reijnlapere/PGG-Ageing-Young/emerging_tech/emerging_tech.md

opkomende technologiën project 
**!belangrijk!** kies nog een licentie, maar vraag waar je deze moet aanduiden/ingeven 

ook nog onduidelijk wat gitignore is.. dus vragen. 

## Visuele weergave opstelling 
<p align="center">
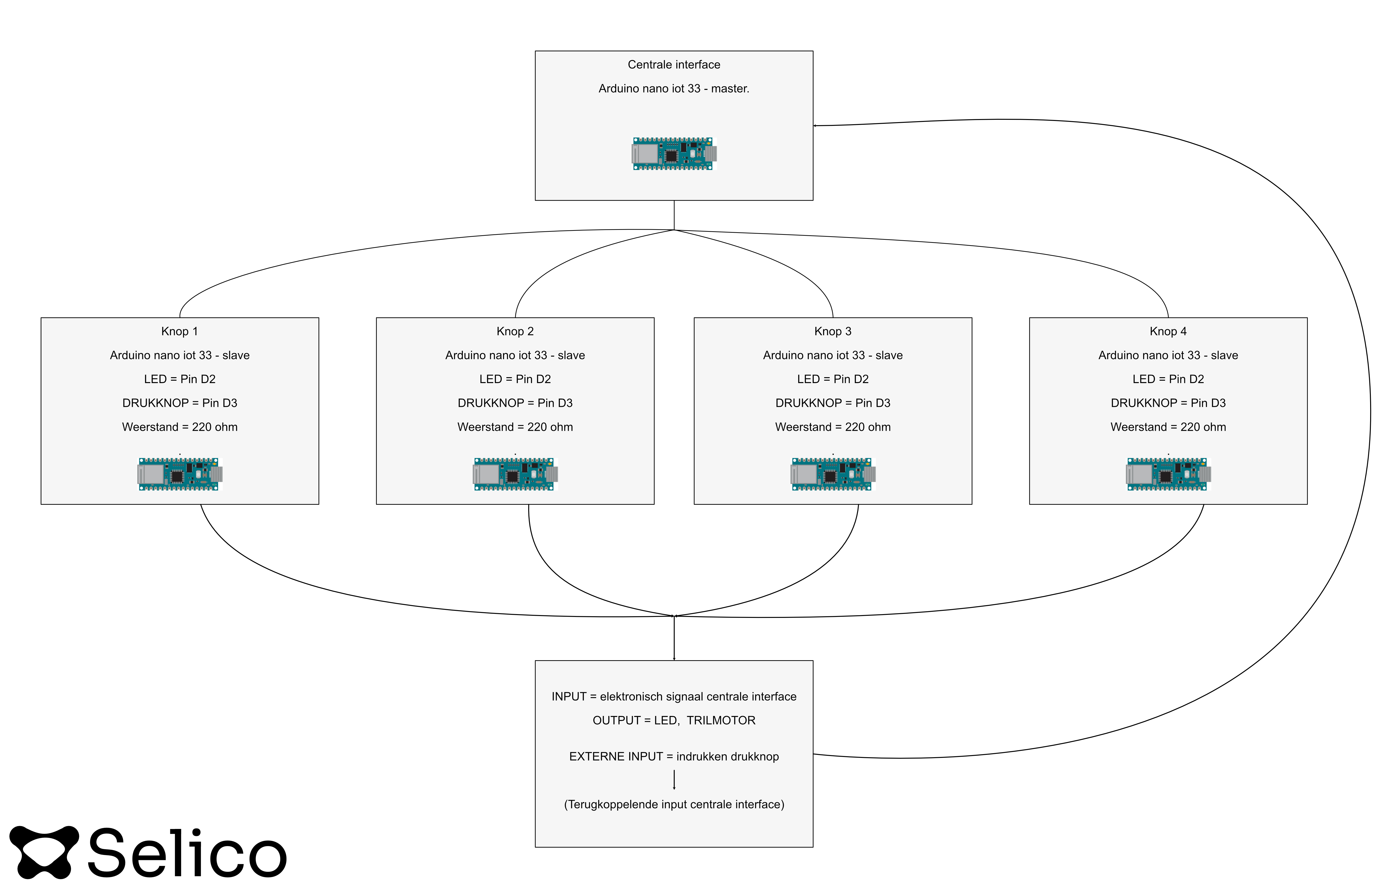
[picture p59: emerging_tech/images/opstelling grafisch.jpg]
  

## Bedradingsschema
