reijnlapere/PGG-Ageing-Young/emerging_tech/imgs/arduino-nano-33-iot-pinout.webp

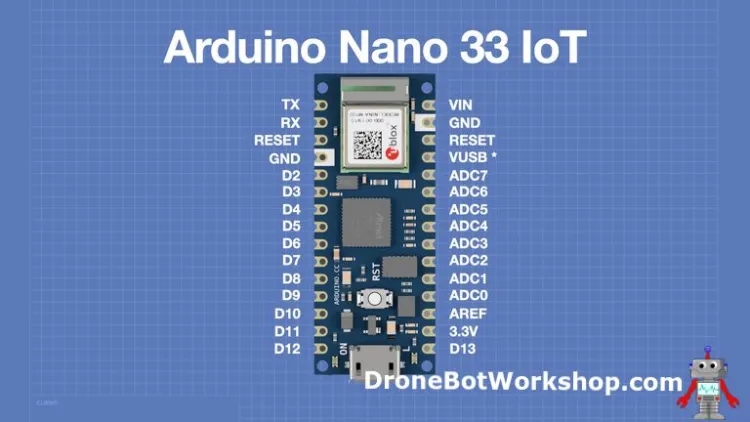
emerging_tech/imgs/arduino-nano-33-iot-pinout.webp
