reijnlapere/PGG-Ageing-Young/images/5WH.png

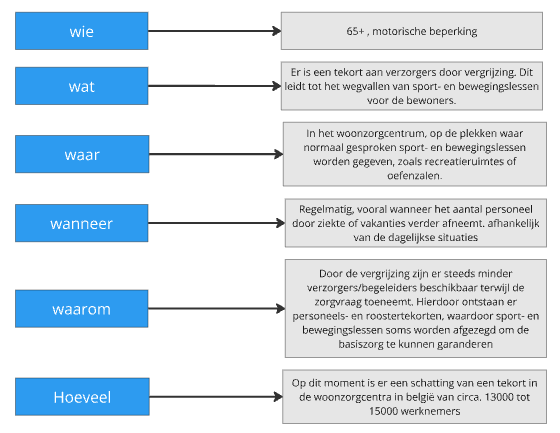
images/5WH.png
