reijnlapere/PGG-Ageing-Young/images/Afbeelding van WhatsApp op 2025-05-18 om 19.23.48_1e9d7f2c.jpg

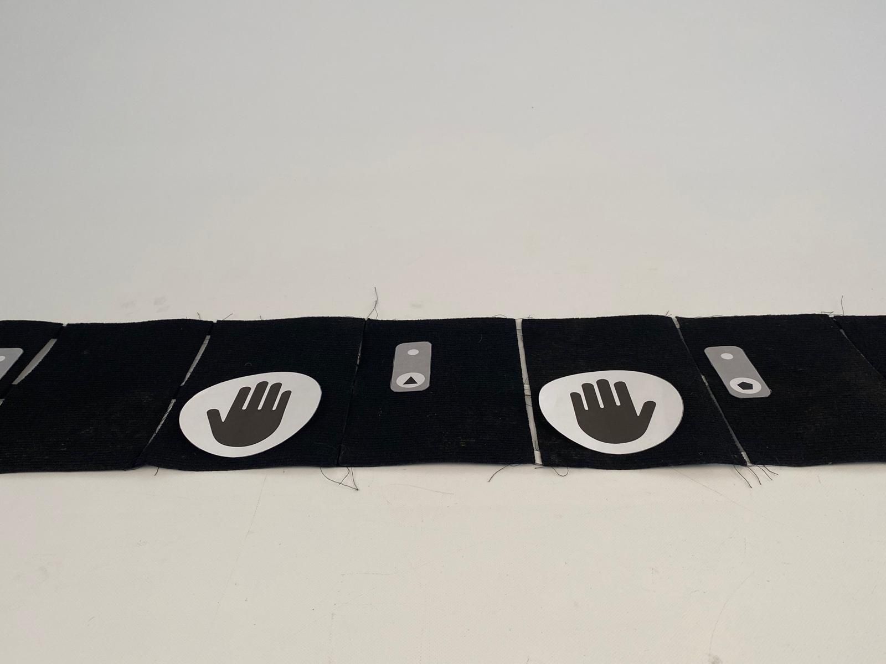
images/Afbeelding van WhatsApp op 2025-05-18 om 19.23.48_1e9d7f2c.jpg
