reijnlapere/PGG-Ageing-Young/images/Afbeelding van WhatsApp op 2025-05-18 om 19.23.48_4a3d5f69.jpg

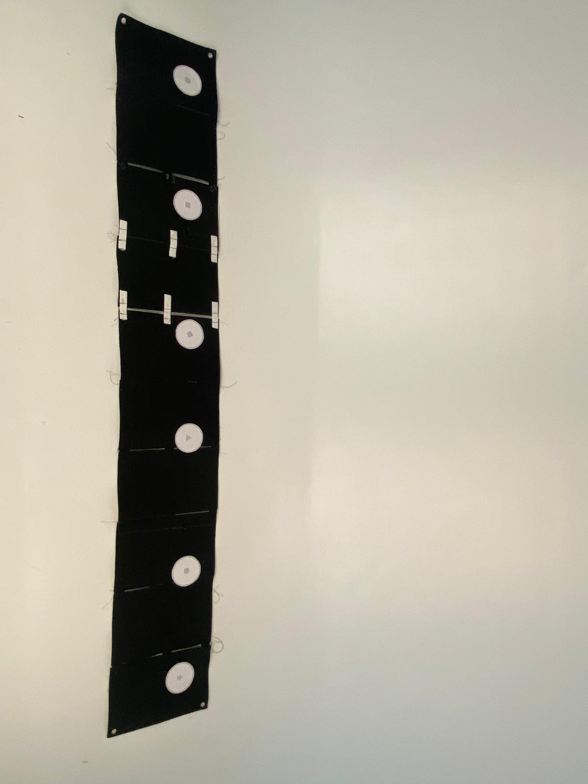
images/Afbeelding van WhatsApp op 2025-05-18 om 19.23.48_4a3d5f69.jpg
