reijnlapere/PGG-Ageing-Young/images/Afbeelding van WhatsApp op 2025-05-18 om 19.23.48_9bfd3e1f.jpg

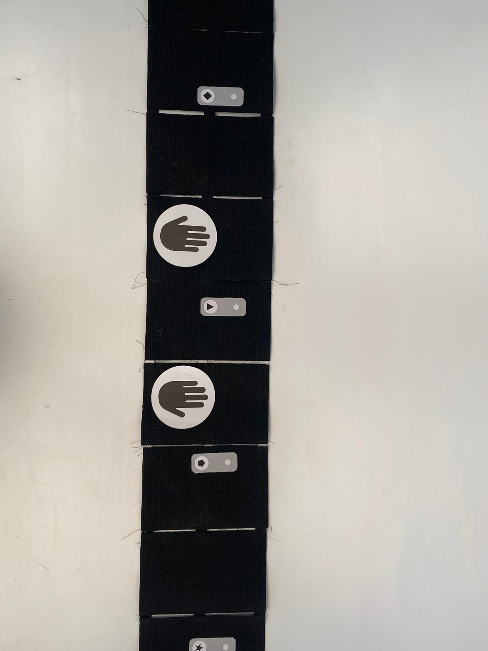
images/Afbeelding van WhatsApp op 2025-05-18 om 19.23.48_9bfd3e1f.jpg
