reijnlapere/PGG-Ageing-Young/images/D2 - 4knop en aanduiding.jpeg

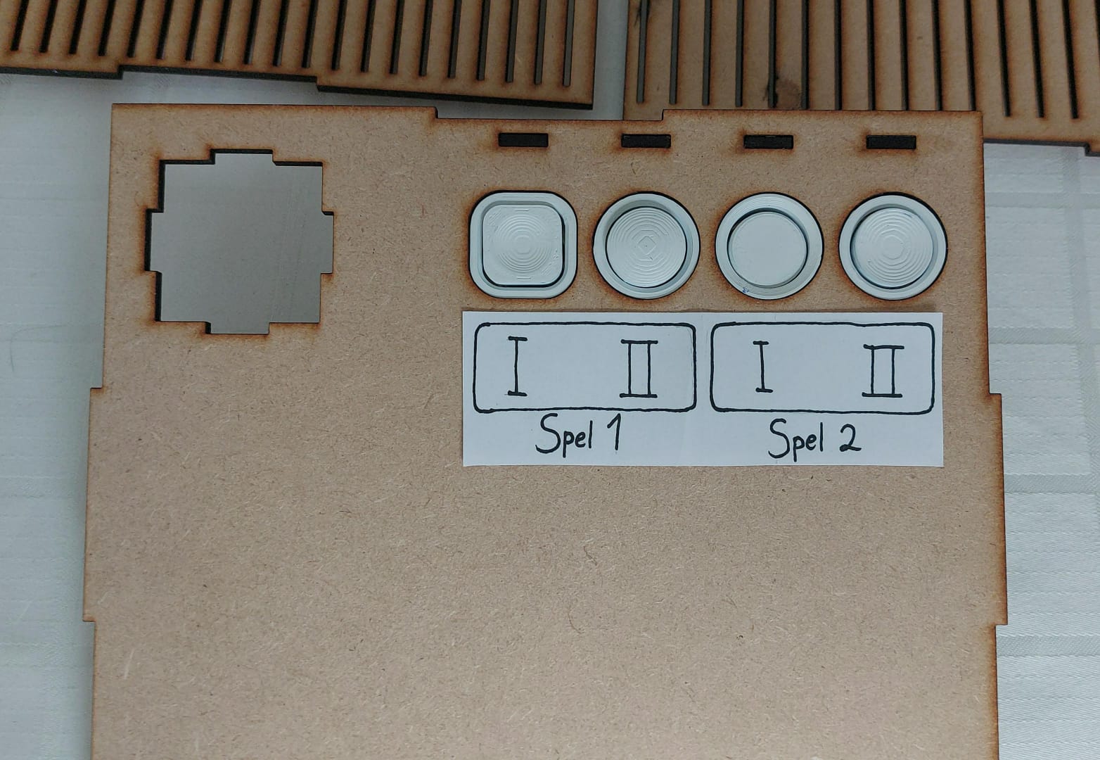
images/D2 - 4knop en aanduiding.jpeg
