reijnlapere/PGG-Ageing-Young/images/D2 - aanduidingen.jpeg

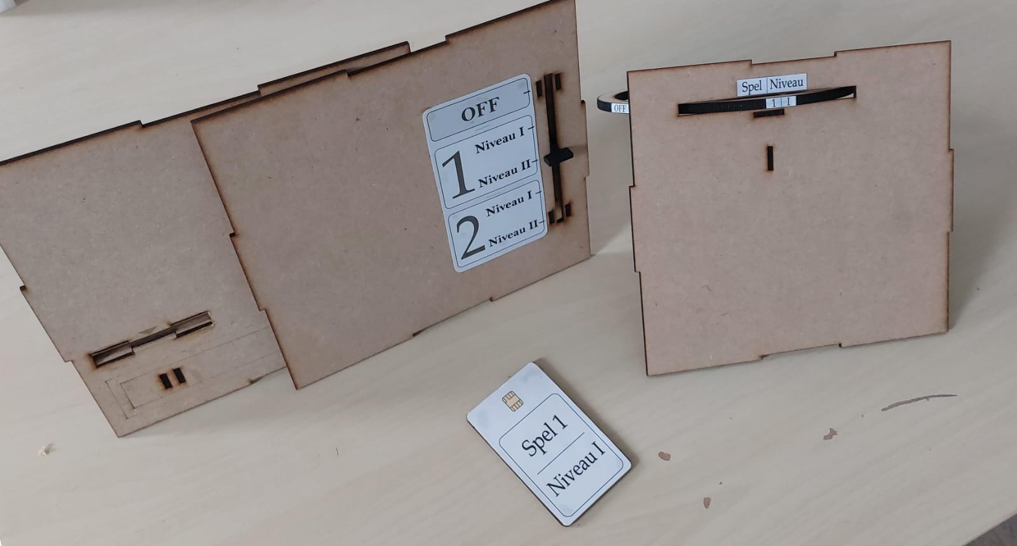
images/D2 - aanduidingen.jpeg
