reijnlapere/PGG-Ageing-Young/images/D2 - dial - NX.png

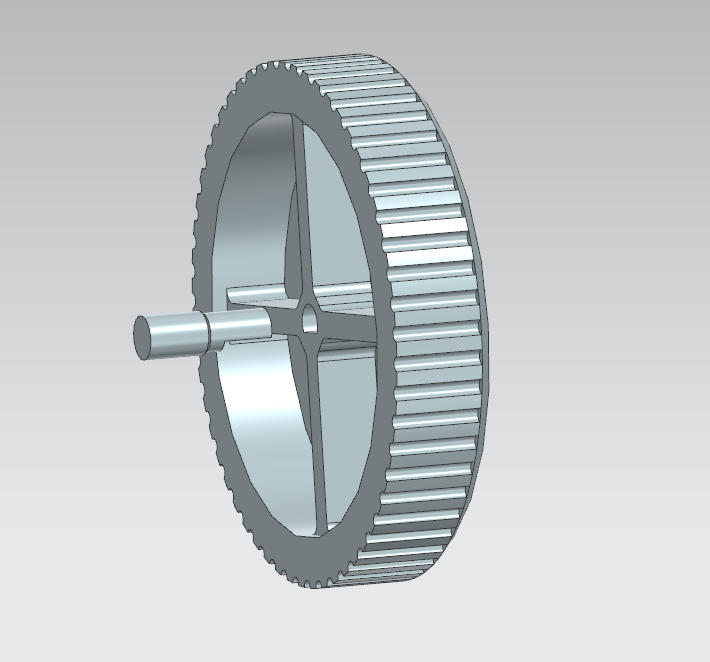
images/D2 - dial - NX.png
