reijnlapere/PGG-Ageing-Young/images/D2 - interchangable.jpeg

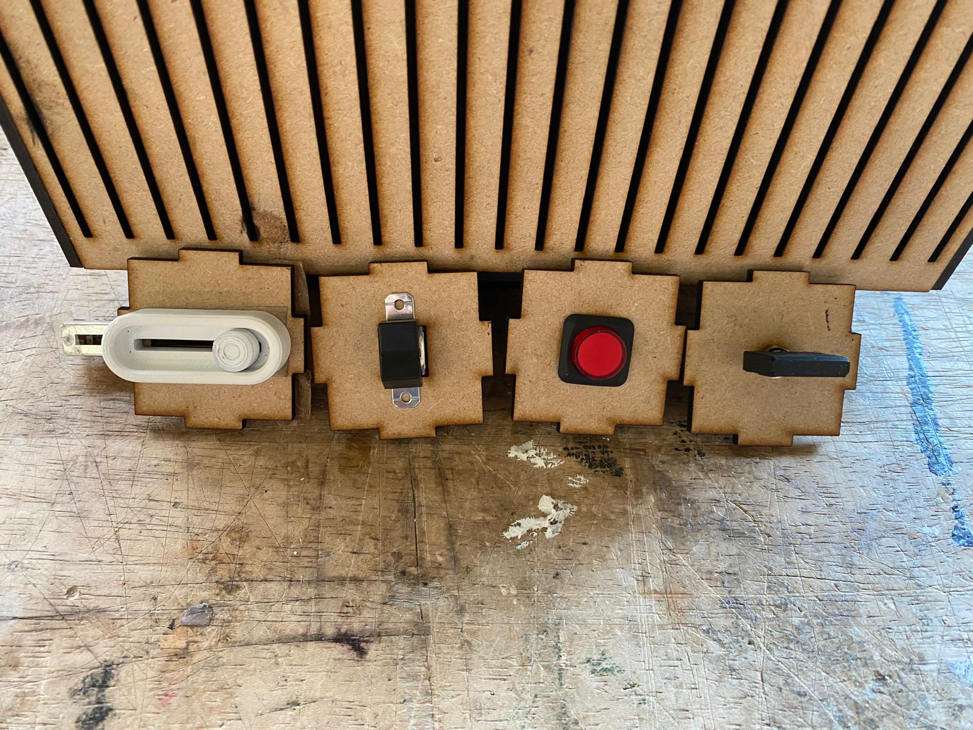
images/D2 - interchangable.jpeg
