reijnlapere/PGG-Ageing-Young/images/D2 - slider - verticaal achterkant.png

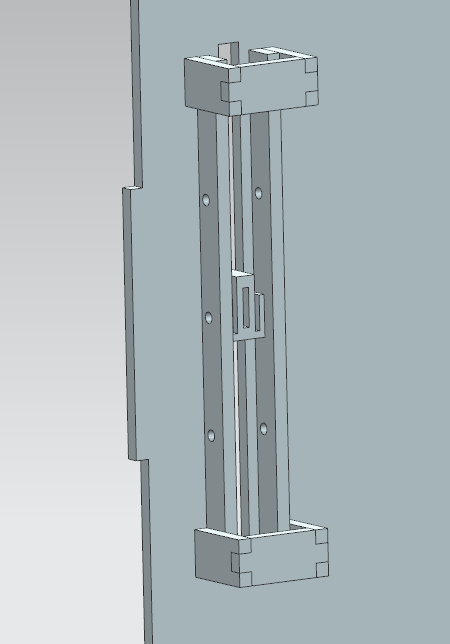
images/D2 - slider - verticaal achterkant.png
