reijnlapere/PGG-Ageing-Young/images/D2-gamecard2.jpg

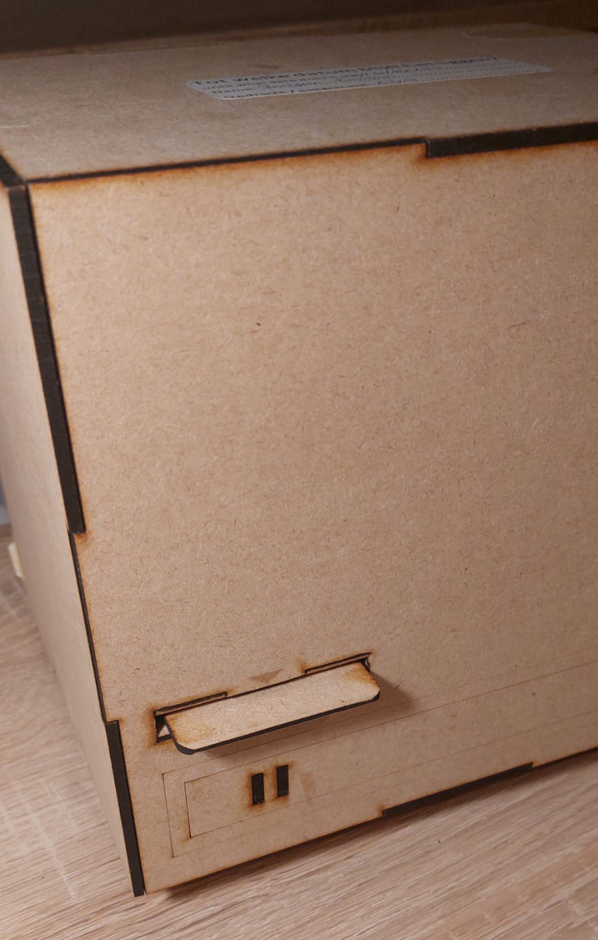
images/D2-gamecard2.jpg
