reijnlapere/PGG-Ageing-Young/images/D2-gamecard.jpeg

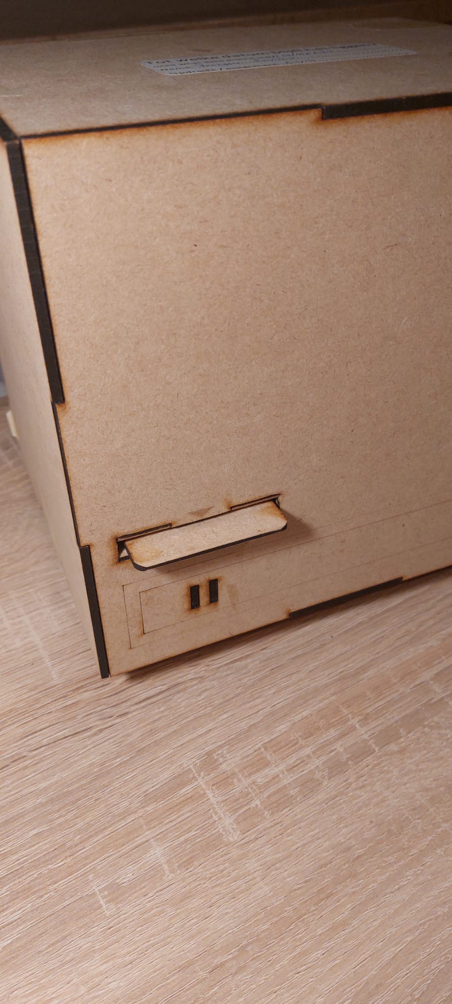
images/D2-gamecard.jpeg
