reijnlapere/PGG-Ageing-Young/images/D2-slider-aanduiding.jpeg

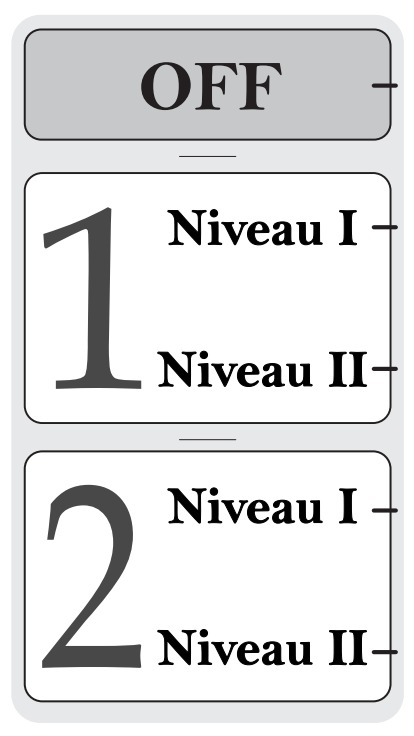
images/D2-slider-aanduiding.jpeg
