reijnlapere/PGG-Ageing-Young/images/Develop IM1.jpeg

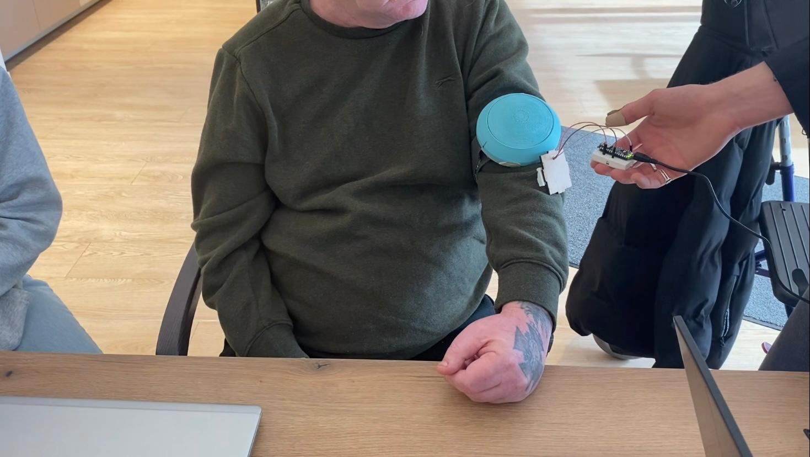
images/Develop IM1.jpeg
