reijnlapere/PGG-Ageing-Young/images/Develop IM3.jpeg

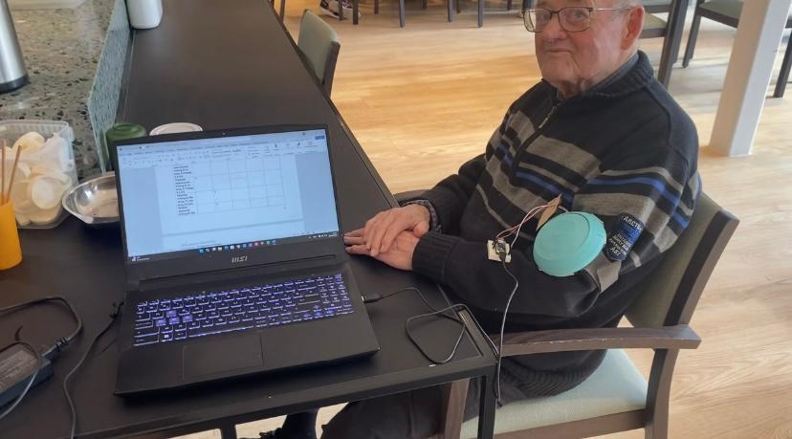
images/Develop IM3.jpeg
