reijnlapere/PGG-Ageing-Young/images/Develop IM5.jpeg

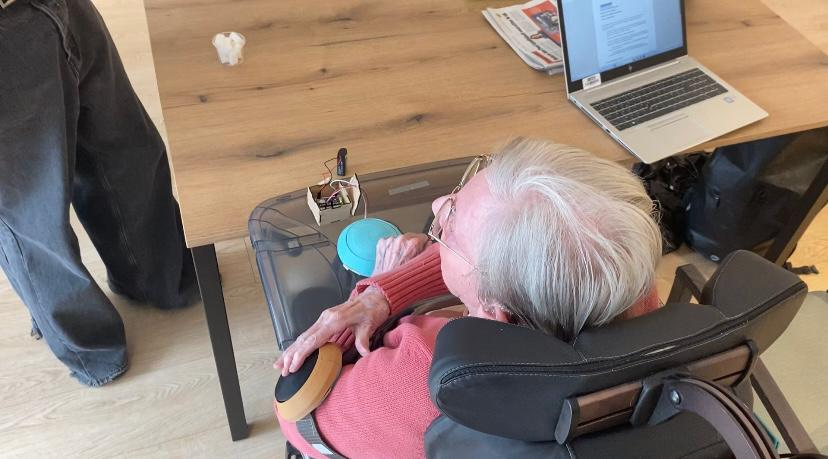
images/Develop IM5.jpeg
