reijnlapere/PGG-Ageing-Young/images/innovatrix.png

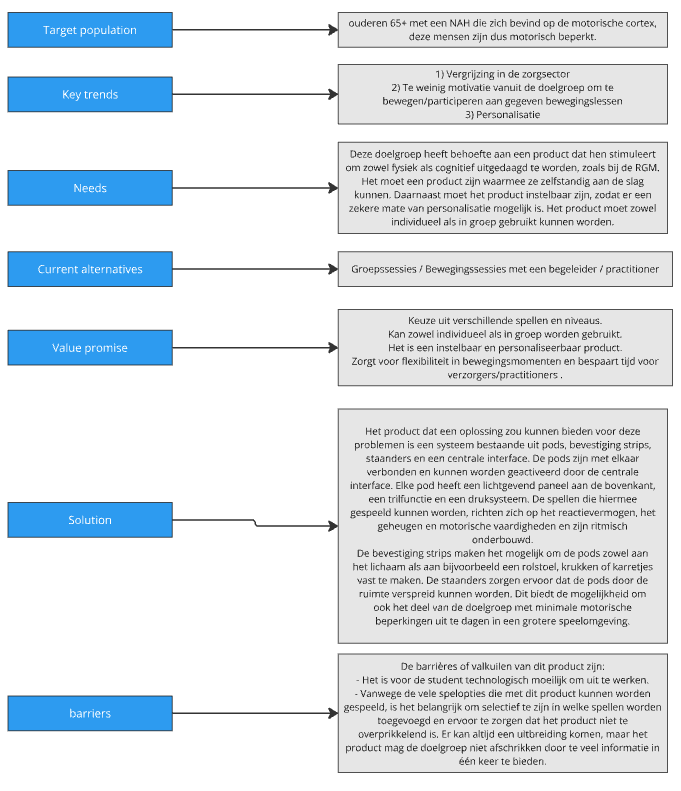
images/innovatrix.png
