reijnlapere/PGG-Ageing-Young/images/interface knopjes.jpg

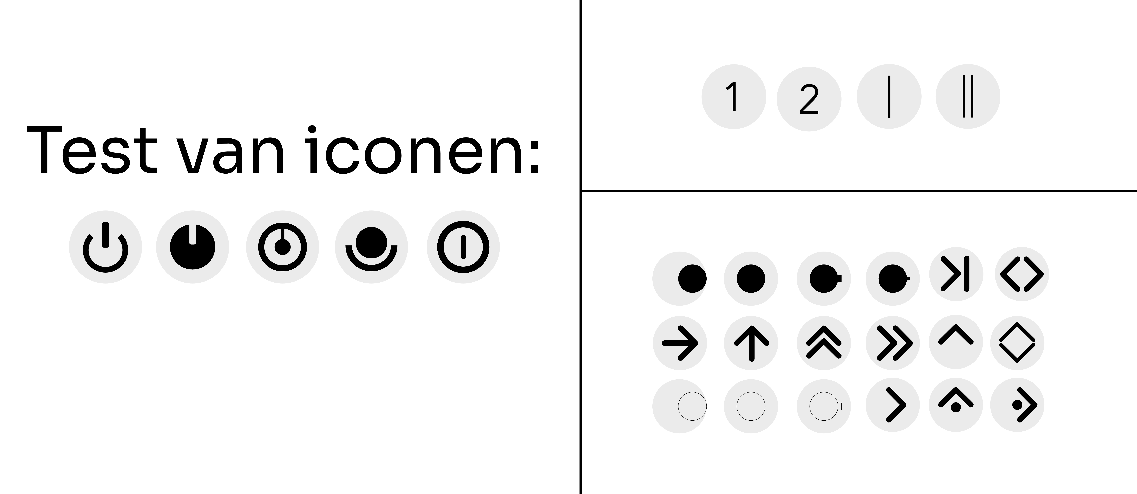
images/interface knopjes.jpg
