reijnlapere/PGG-Ageing-Young/images/POD_AANSPAN1.jpeg

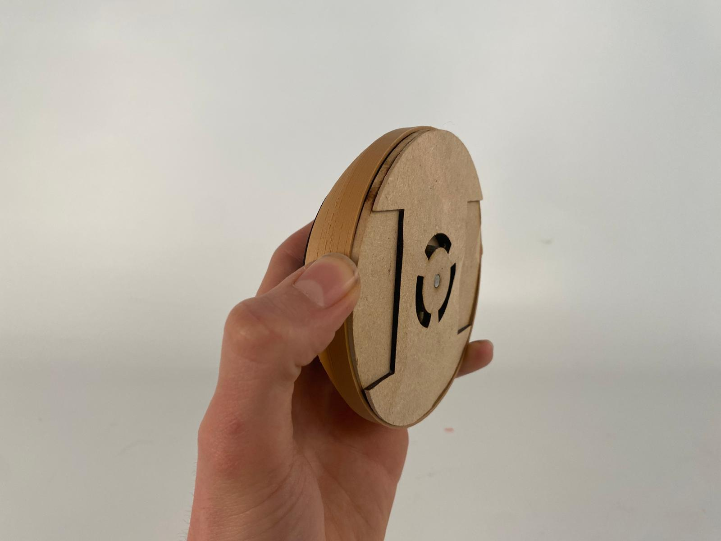
images/POD_AANSPAN1.jpeg
