reijnlapere/PGG-Ageing-Young/images/Render24 dial Finn.png

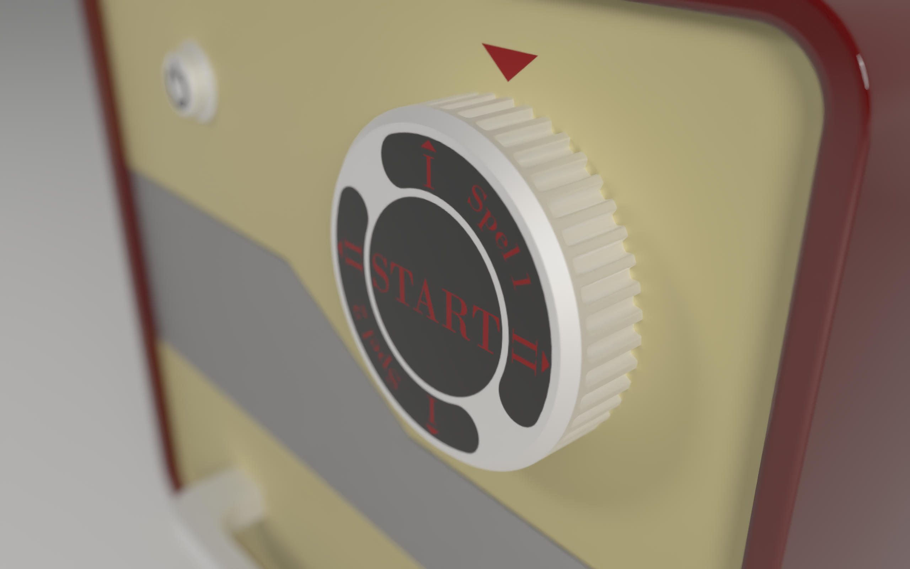
images/Render24 dial Finn.png
