reijnlapere/PGG-Ageing-Young/images/Render27 open Finnal.png

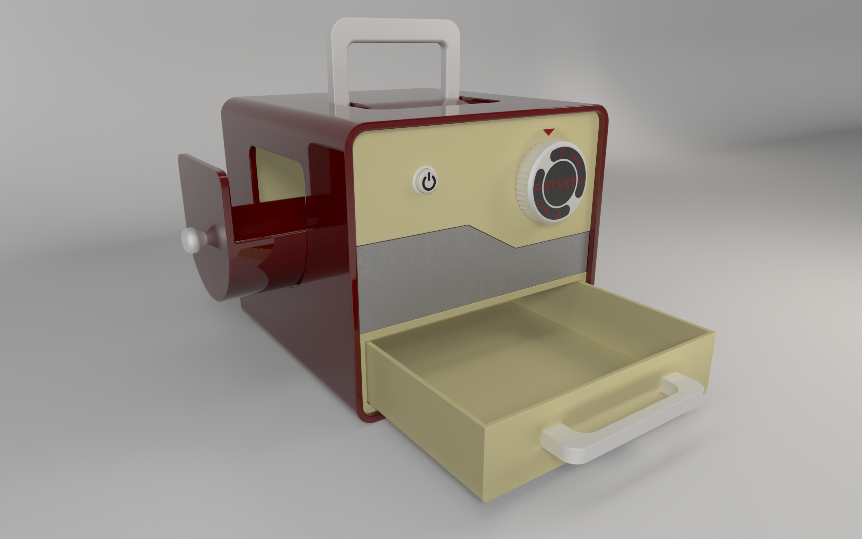
images/Render27 open Finnal.png
