reijnlapere/PGG-Ageing-Young/images/Schermafbeelding 2025-05-03 114111.png

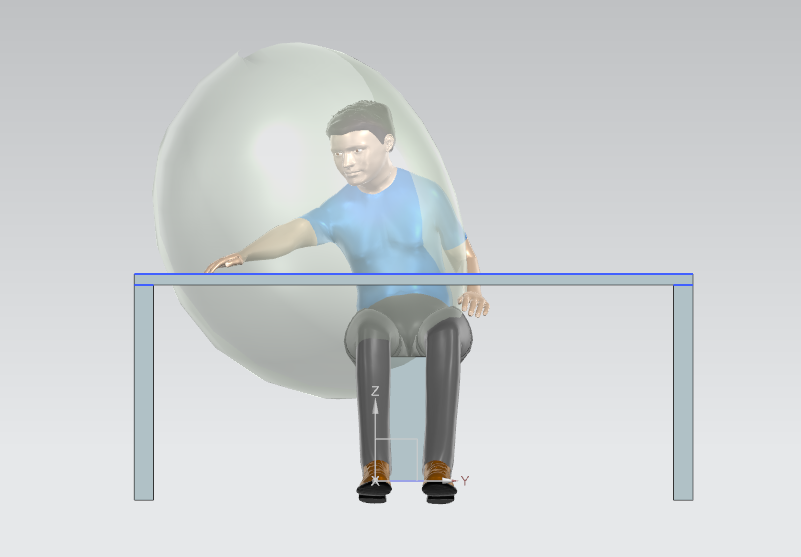
images/Schermafbeelding 2025-05-03 114111.png
