reijnlapere/PGG-Ageing-Young/images/Schermafbeelding 2025-05-21 014410.png

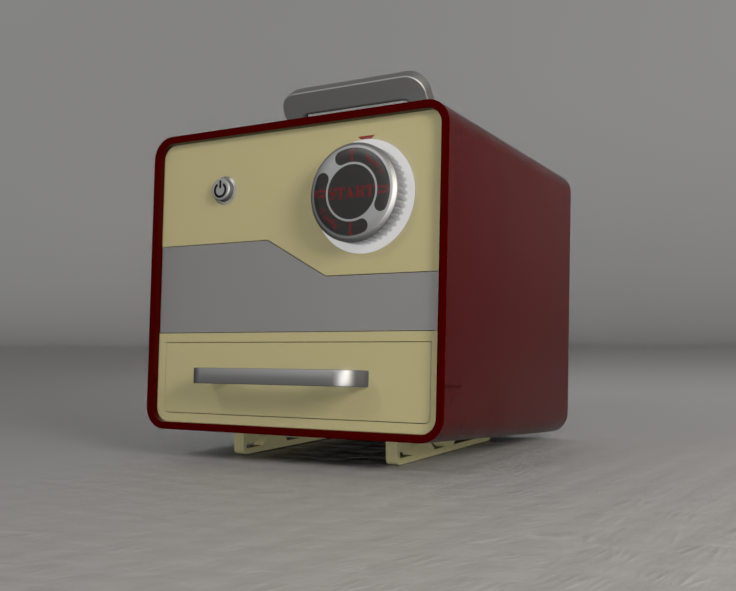
images/Schermafbeelding 2025-05-21 014410.png
