reijnlapere/PGG-Ageing-Young/images/Schermafbeelding 2025-05-21 024110.png

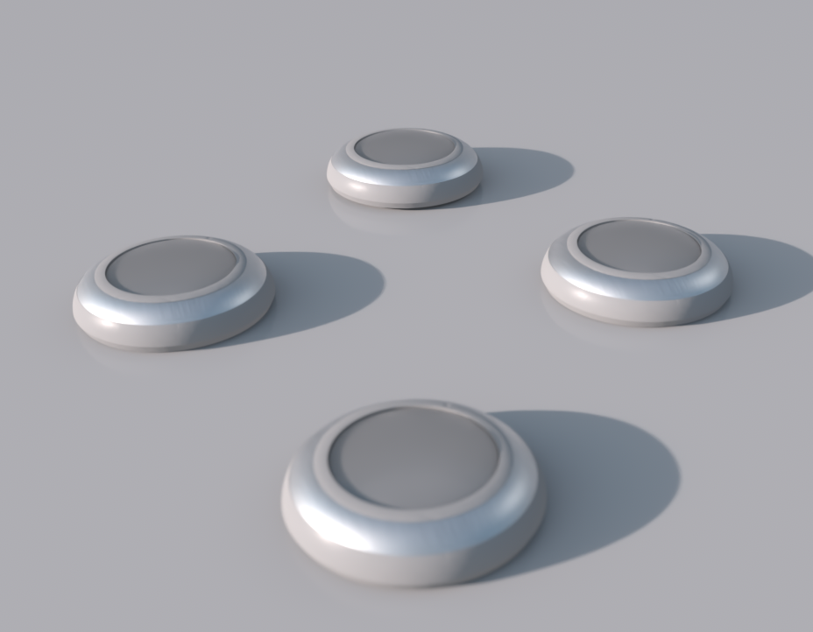
images/Schermafbeelding 2025-05-21 024110.png
