reijnlapere/PGG-Ageing-Young/images/Selico Movie Thumbnail.png

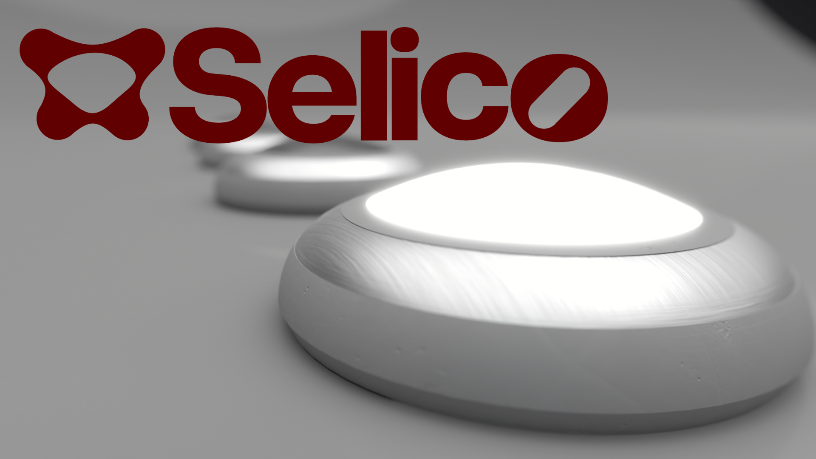
images/Selico Movie Thumbnail.png
