reijnlapere/PGG-Ageing-Young/images/simple (1).jpg

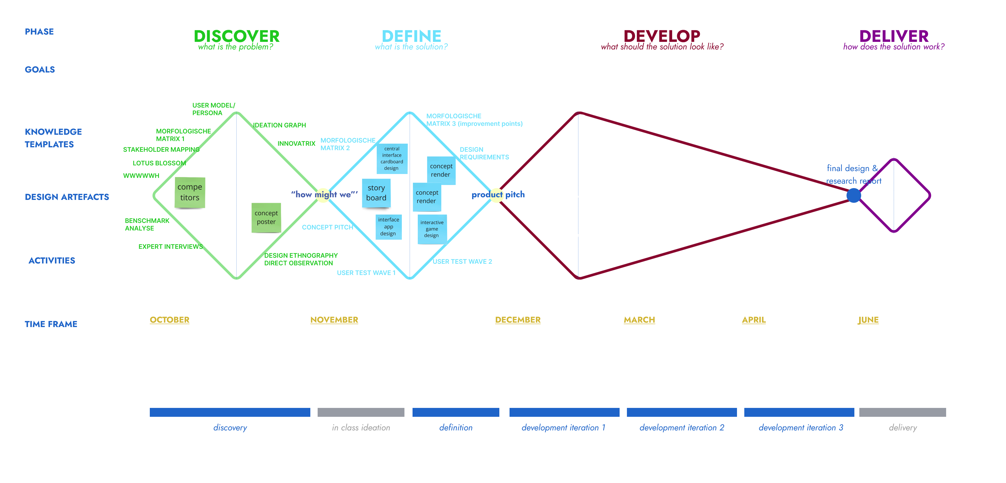
images/simple (1).jpg
