reijnlapere/PGG-Ageing-Young/images/simple (2).jpg

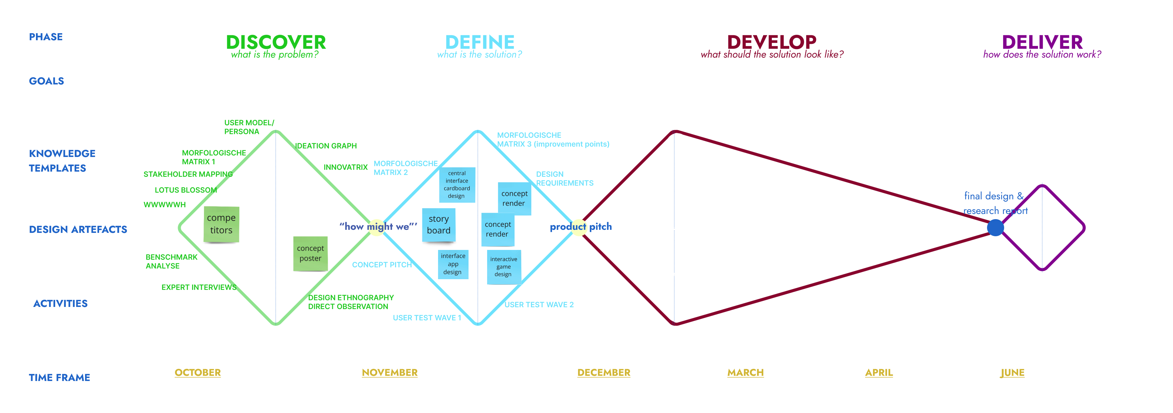
images/simple (2).jpg
