reijnlapere/PGG-Ageing-Young/images/storyboard.jpg

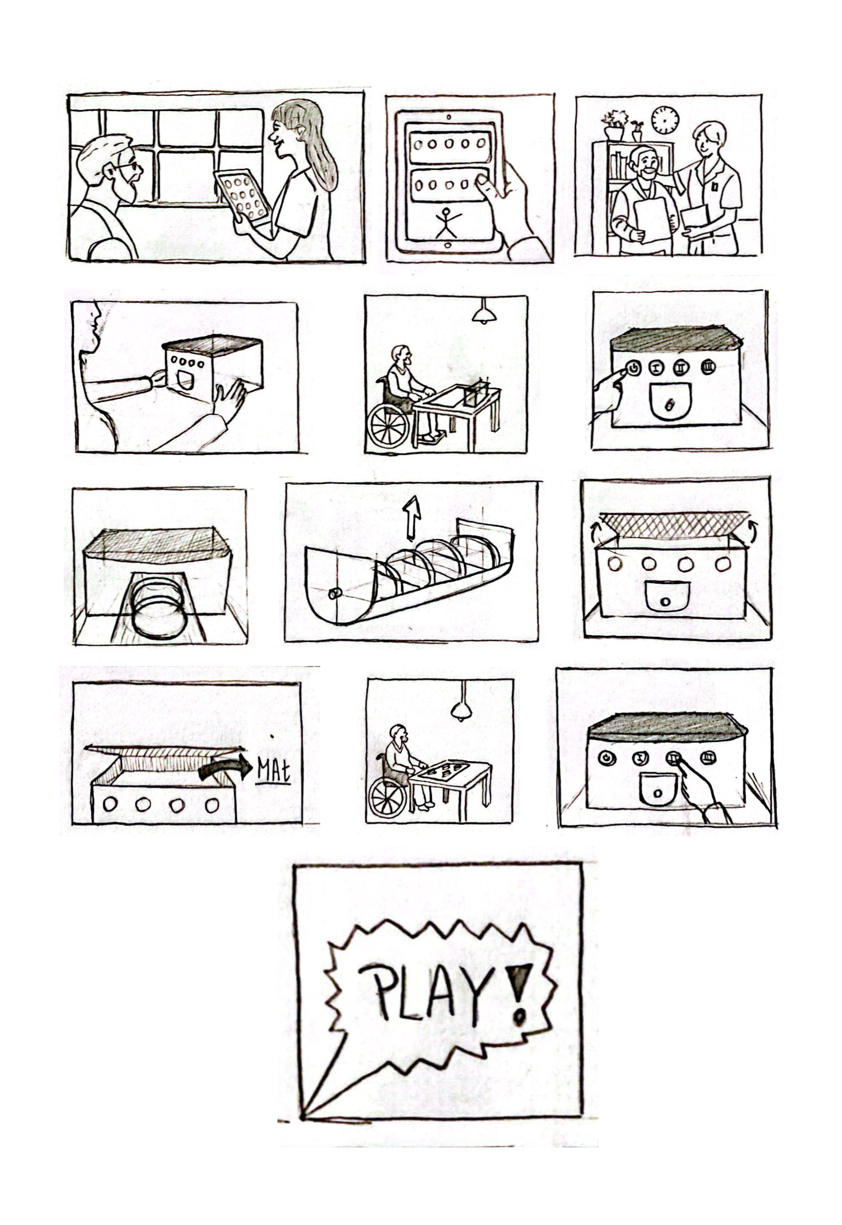
images/storyboard.jpg
