reijnlapere/PGG-Ageing-Young/images/Tekening verbinding.png

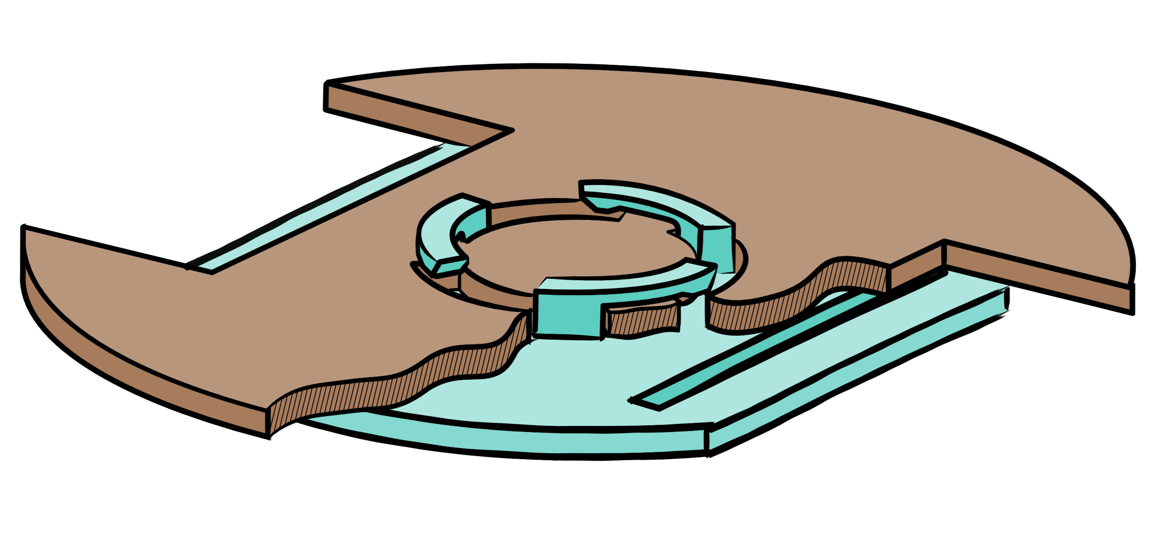
images/Tekening verbinding.png
