reijnlapere/PGG-Ageing-Young/images/Userflow.png

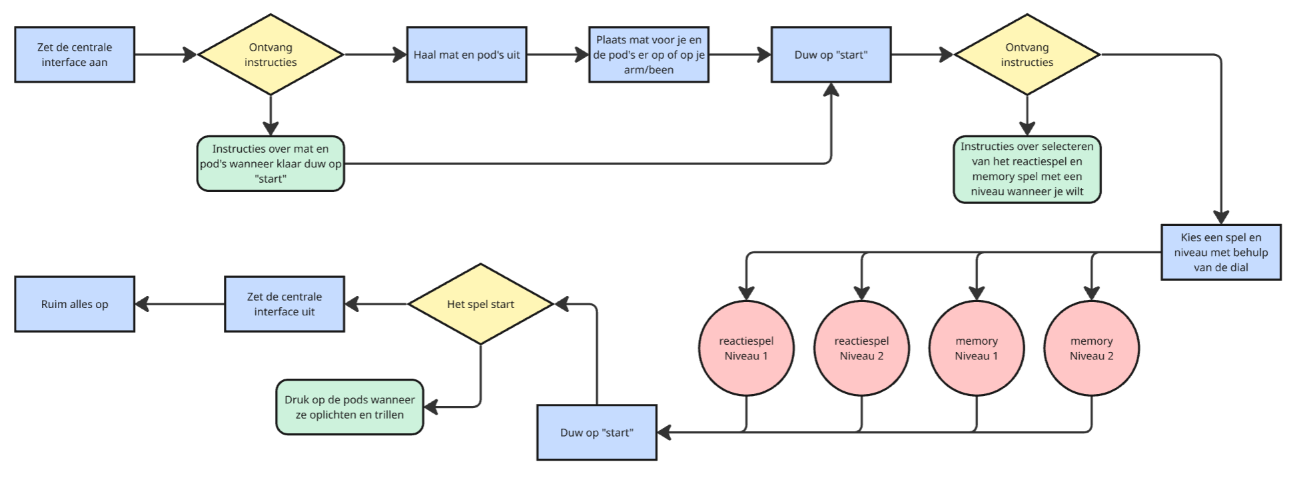
images/Userflow.png
