reijnlapere/PGG-Ageing-Young/(list of files, cad)

Other CAD files:
nx/pods_develop1/onderkant1.prt
nx/pods_develop1/onderkant2.prt
nx/pods_develop1/onderkant3.prt
nx/pods_develop1/pin-houder-groot.prt
nx/pods_develop1/pin-houder.prt
nx/pods_develop1/pods pt1 helft 1.prt
nx/pods_develop1/pods pt1 helft 2.prt
nx/pods_develop1/pods pt1.prt
nx/pods_develop1/pods pt2 - bovenkant print (95 - tall - met aanpassing).prt
nx/pods_develop1/pods pt2 - bovenkant print (95 - tall - zonder aanpassing).prt
nx/pods_develop1/pods pt2 - bovenkant print.prt
nx/pods_develop1/pods pt2.prt
nx/pods_develop1/shell groot.prt
nx/pods_develop1/shell klein.prt
