reijnlapere/PGG-Ageing-Young/emerging_tech/code/basisprogramma's/seriele communicatie nano 33 IoT en nano/code_Bidirectioneel_Nano/code_Bidirectioneel_Nano.ino

// arduino nano, ontvanger. 
#include <SoftwareSerial.h>

// Pin 10 = RX, Pin 11 = TX
SoftwareSerial mySerial(10, 11);

void setup() {
  Serial.begin(9600);
  mySerial.begin(9600);

  Serial.println("Klaar om data te ontvangen...");
}

void loop() {
  if (mySerial.available()) {
    String ontvangen = mySerial.readStringUntil('\n');
    Serial.print("Ontvangen: ");
    Serial.println(ontvangen);

    // Antwoord terugsturen
    mySerial.println("Hallo terug van Nano!");
    Serial.println("Antwoord verzonden.");
  }
}
